MrOaks/sofle-choc-mroaks/hardware/3d_print/Sofle Case.stl

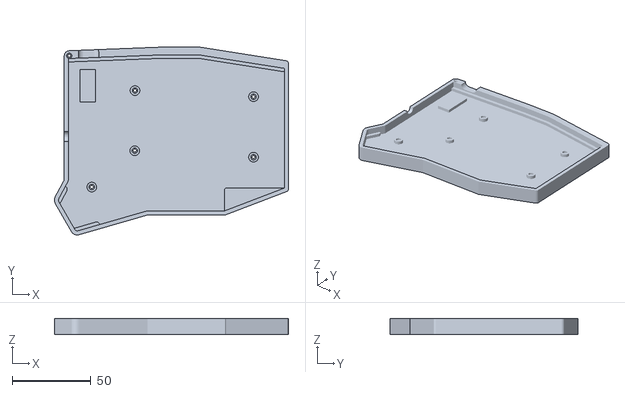
[picture p2: CAD file, 2026-11-02]
hardware/3d_print/Sofle Case.stl
149.0 x 119.7 x 10.3
