MrOaks/sofle-choc-mroaks/hardware/cnc/Madera2.dxf

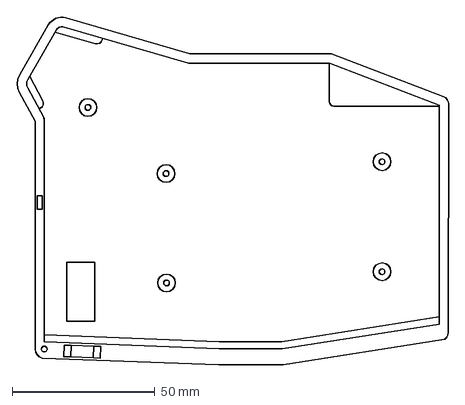
[picture p3: CAD file, 2026-11-02]
hardware/cnc/Madera2.dxf
151.3 x 122.2 mm
