MrOaks/sofle-choc-mroaks/hardware/3d_print/PCB Sofle.stl

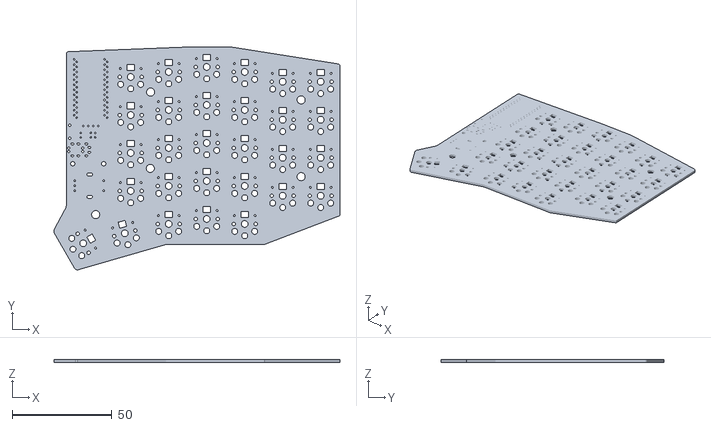
[picture p4: CAD file, 2026-11-02]
hardware/3d_print/PCB Sofle.stl
143.4 x 111.8 x 1.60
