MrOaks/sofle-choc-mroaks/hardware/cnc/Sofle Case Madera.dxf

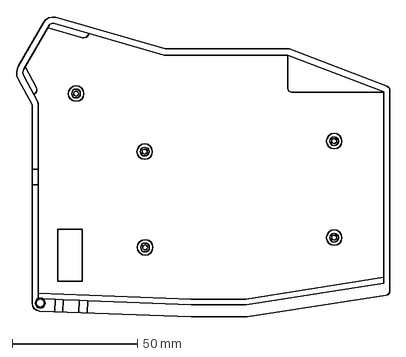
[picture p5: CAD file, 2026-11-02]
hardware/cnc/Sofle Case Madera.dxf
149.3 x 120.1 mm
