MrOaks/sofle-choc-mroaks/hardware/3d_print/Sofle+Choc+Case+Battery+without+3.5mm.stl

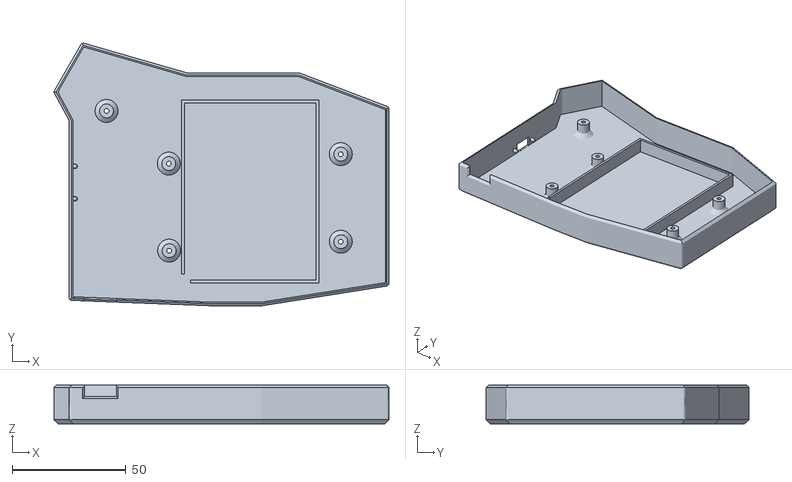
[picture p6: CAD file, 2026-11-02]
hardware/3d_print/Sofle+Choc+Case+Battery+without+3.5mm.stl
147.3 x 115.5 x 17.0
