MrOaks/sofle-choc-mroaks/hardware/cnc/cepillado2.dxf

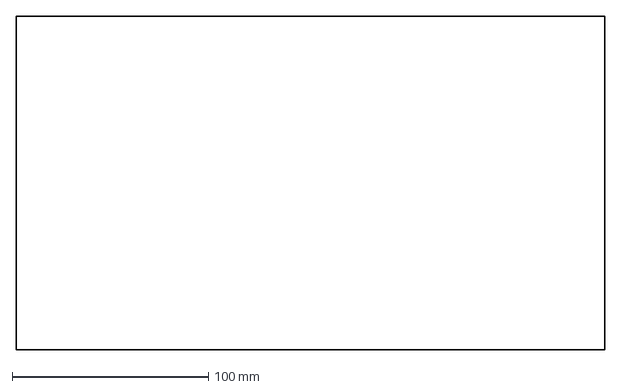
[picture p7: CAD file, 2026-11-02]
hardware/cnc/cepillado2.dxf
300.0 x 170.0 mm
