MrOaks/sofle-choc-mroaks/hardware/3d_print/Foam Template.stl

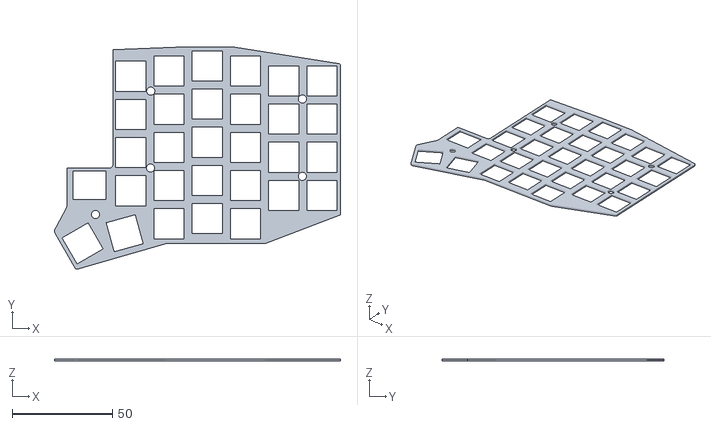
[picture p8: CAD file, 2026-11-02]
hardware/3d_print/Foam Template.stl
142.4 x 110.7 x 1.20
