MrOaks/sofle-choc-mroaks/hardware/cnc/MaderaCNCTRasera.dxf

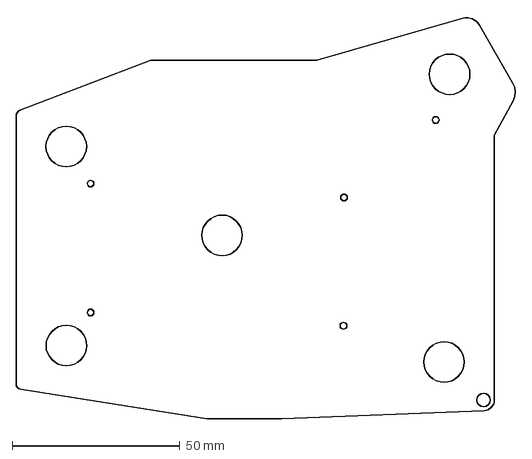
[picture p9: CAD file, 2026-11-02]
hardware/cnc/MaderaCNCTRasera.dxf
149.3 x 120.1 mm
