MrOaks/sofle-choc-mroaks/hardware/cnc/OLEDS.dxf

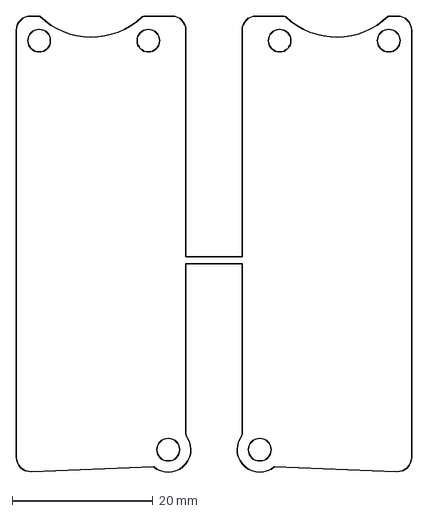
[picture p10: CAD file, 2026-11-02]
hardware/cnc/OLEDS.dxf
56.1 x 65.1 mm
