MrOaks/sofle-choc-mroaks/hardware/cnc/cepillado1.dxf

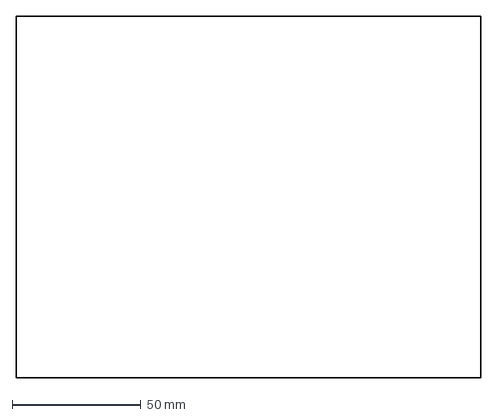
[picture p11: CAD file, 2026-11-02]
hardware/cnc/cepillado1.dxf
180.0 x 140.0 mm
