MrOaks/sofle-choc-mroaks/hardware/cnc/Madera2Trasera.dxf

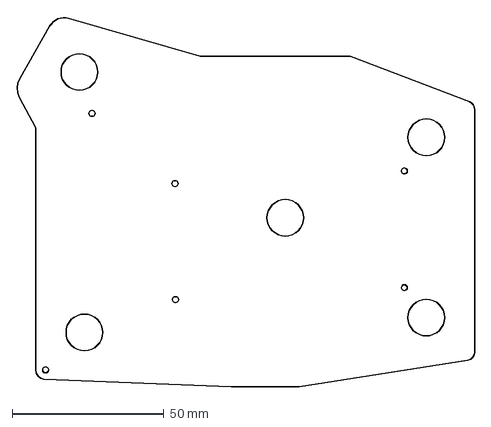
[picture p12: CAD file, 2026-11-02]
hardware/cnc/Madera2Trasera.dxf
151.3 x 122.2 mm
