MrOaks/sofle-choc-mroaks/hardware/cnc/Sofle Case Metacrilato.dxf

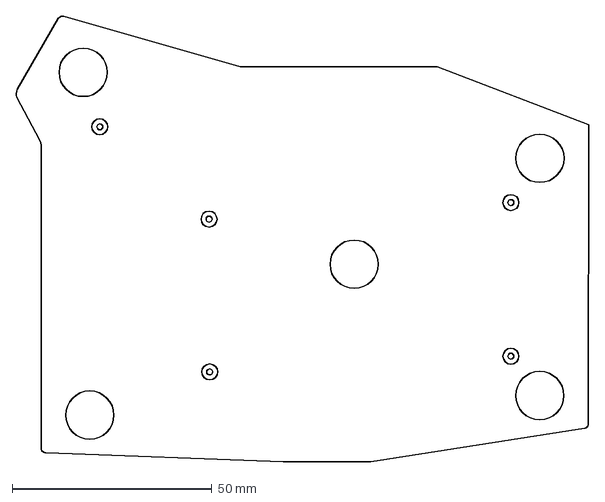
[picture p13: CAD file, 2026-11-02]
hardware/cnc/Sofle Case Metacrilato.dxf
143.4 x 111.8 mm
