MrOaks/sofle-choc-mroaks/(list of files, drawings)

Other design files:
hardware/pcb/SofleKeyboard.dsn
