MrOaks/sofle-choc-mroaks/(commit log)

2026-11-02 feat: Add CNC/STL hardware files, logos, and update firmware with Luna pet and build fixes
    [Foam Template.stl, Madera2.dxf, Madera2Trasera.dxf, MaderaCNCTRasera.dxf, OLEDS.dxf, PCB Sofle.stl, Sofle Case Madera.dxf, Sofle Case Metacrilato.dxf]
2026-11-09 fix(firmware): Update Luna dog OLED animation, resolve symbols and keyboard definition
    [config.h, keymap.c]
2026-11-09 fix(build): Use native make build target, qmk_home config, and step summaries
    [config.h]
2026-11-14 feat(hardware): Add KiCad PCB design files and production Gerbers for Sofle Choc
    [SofleKeyboard.dsn, SofleKeyboard.kicad_pcb, SofleKeyboard.sch, SofleKeyboardTopPlate.kicad_pcb]
2026-11-14 docs: Add comprehensive Sofle Choc assembly build guide and illustrations
2026-11-14 docs: Track keymap discrepancies and proposed code corrections
2026-11-14 fix(oled): Rename keyboard pet mascot to Ikki the Dog across firmware and docs
    [config.h, keymap.c]
2026-11-14 fix(rgb): Remove legacy downlight turn-off in layer 0 and enable split count
    [config.h, keymap.c]
